charclo/Cheap-FOCer-2/source/PNGs/Back.PNG

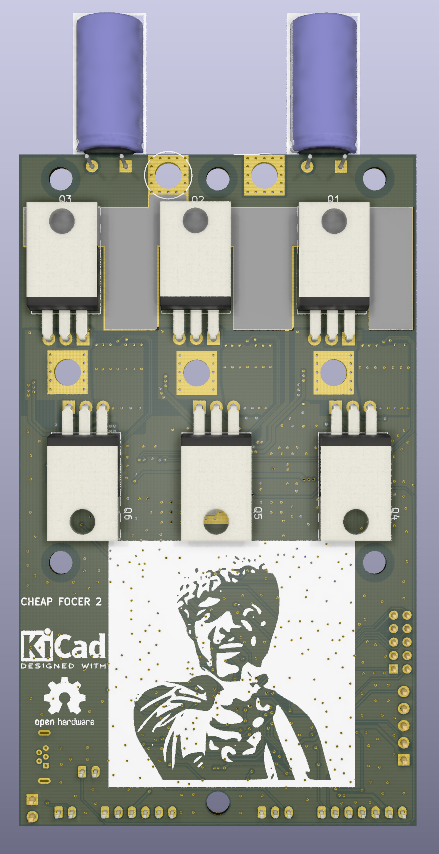
source/PNGs/Back.PNG
