charclo/Cheap-FOCer-2/source/PNGs/pinout.PNG

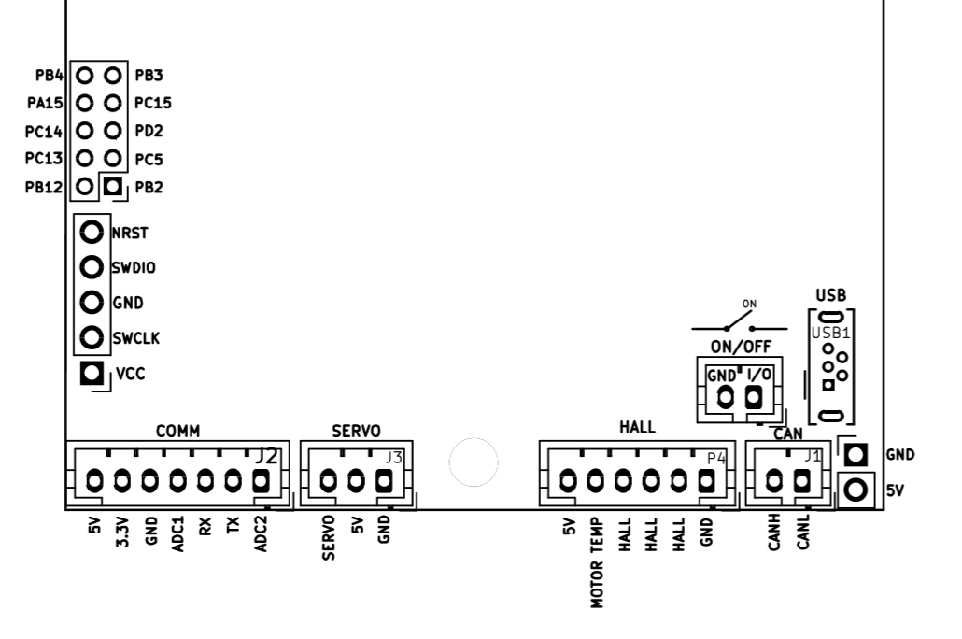
source/PNGs/pinout.PNG
