charclo/Cheap-FOCer-2/source/bom/LCSC BOM Cheap FOCer 2.xlsx

LCSC Part Number | Manufacture Part Number | Manufacturer | Customer NO. | Package | Description | RoHS | Order Qty. | Min\Mult Order Qty. | Unit Price | Order Price
C153035 | FS55X106K101EHG | PSA(Prosperity Dielectrics) |  | 2220 | Multilayer Ceramic Capacitors MLCC - SMD/SMT 10uF 100V 2220 RoHS | Yes | 3 | 1\1 | $0.516667 | $3.1
C266430 | SMNR6028-220MT | SXN(Shun Xiang Nuo Elec) |  | SMD,6x6x3mm | Inductors (SMD) SMD,6x6x3mm RoHS | Yes | 5 | 5\5 | $0.09423 | $0.47
C385986 | HMK325C7475KMHPE | Taiyo Yuden |  | 1210 | Multilayer Ceramic Capacitors MLCC - SMD/SMT 4.7uF 100V 1210 RoHS | Yes | 2 | 1\1 | $0.251515 | $1.01
C396088 | SE60210GA | SINO-IC |  | TO-220 | MOSFET N Channel 60V 210A 4V @ 250uA 2.6mΩ @ 20A,10V TO-220 RoHS | Yes | 6 | 1\1 | $0.443939 | $5.33
C437643 | 63ZLJ330M10X20 | Rubycon |  | Radial,10x20mm | Aluminum Electrolytic Capacitors - Leaded 330uF ±20% 63V Radial,10x20mm RoHS | Yes | 2 | 1\1 | $0.284848 | $1.14
