charclo/Cheap-FOCer-2/Schematic.pdf

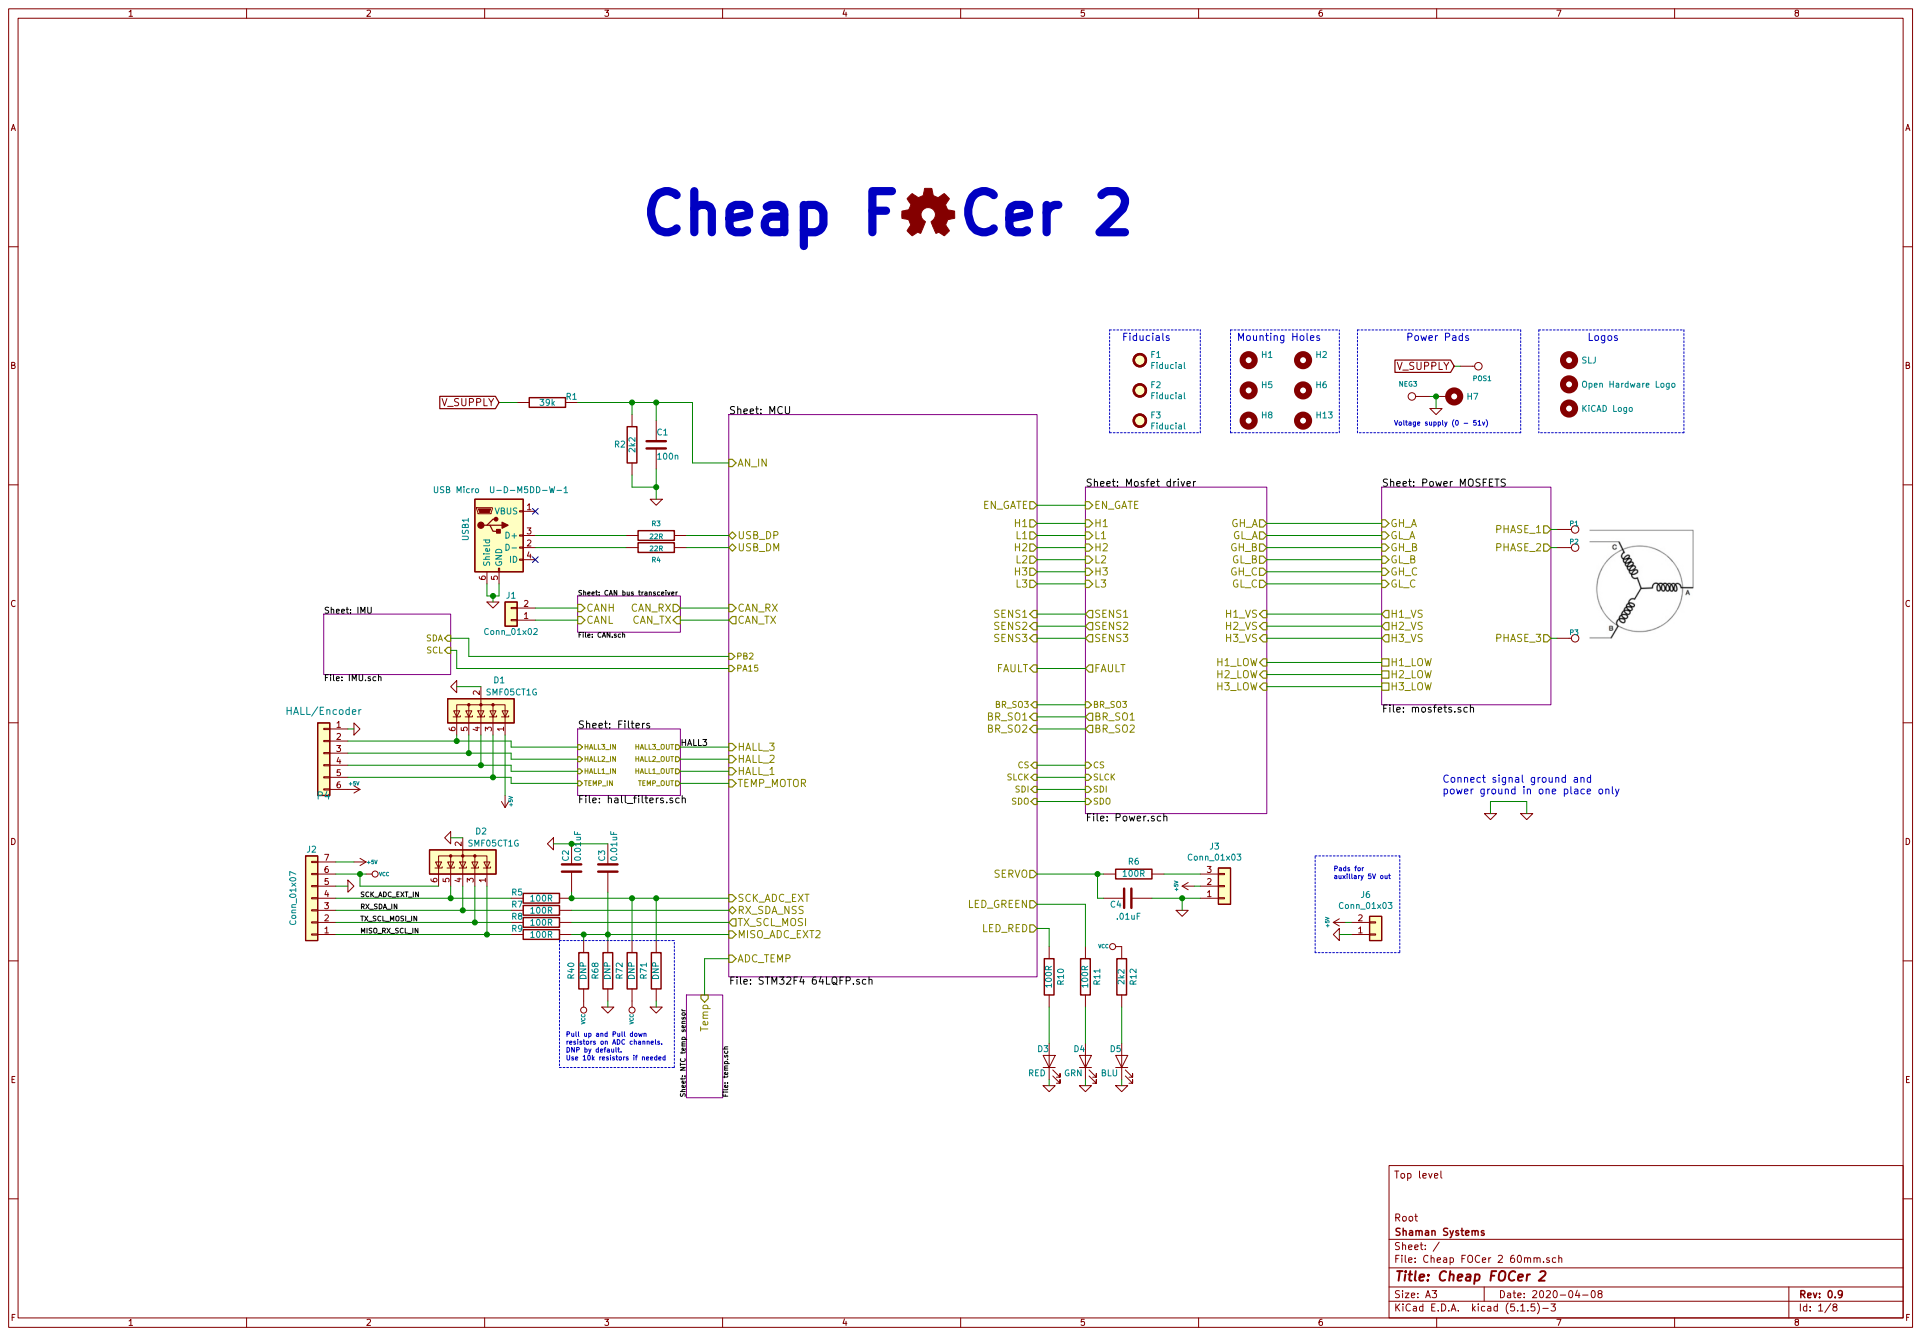
[picture p11: page 1]

power ground in one place only

Pull up and Pull down resistors on ADC channels. DNP by default. Use 10k resistors if needed

File: Cheap FOCer 2 60mm.sch Sheet: / Shaman Systems Root Top level

Id: 1/8 Title: Cheap FOCer 2

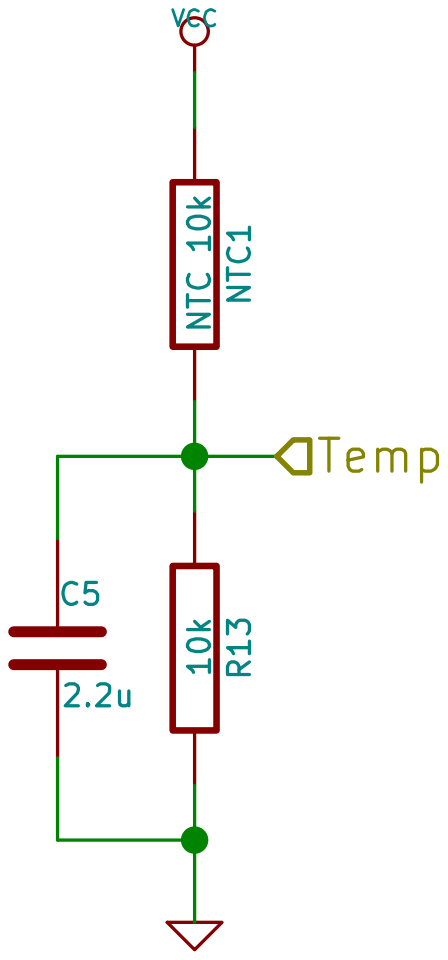
[picture p12: page 2]

Shaman Systems Root Top level 10k R13 C5

Sheet: /NTC temp sensor/
File: temp.sch
Id: 2/8 Title: Cheap FOCer 2

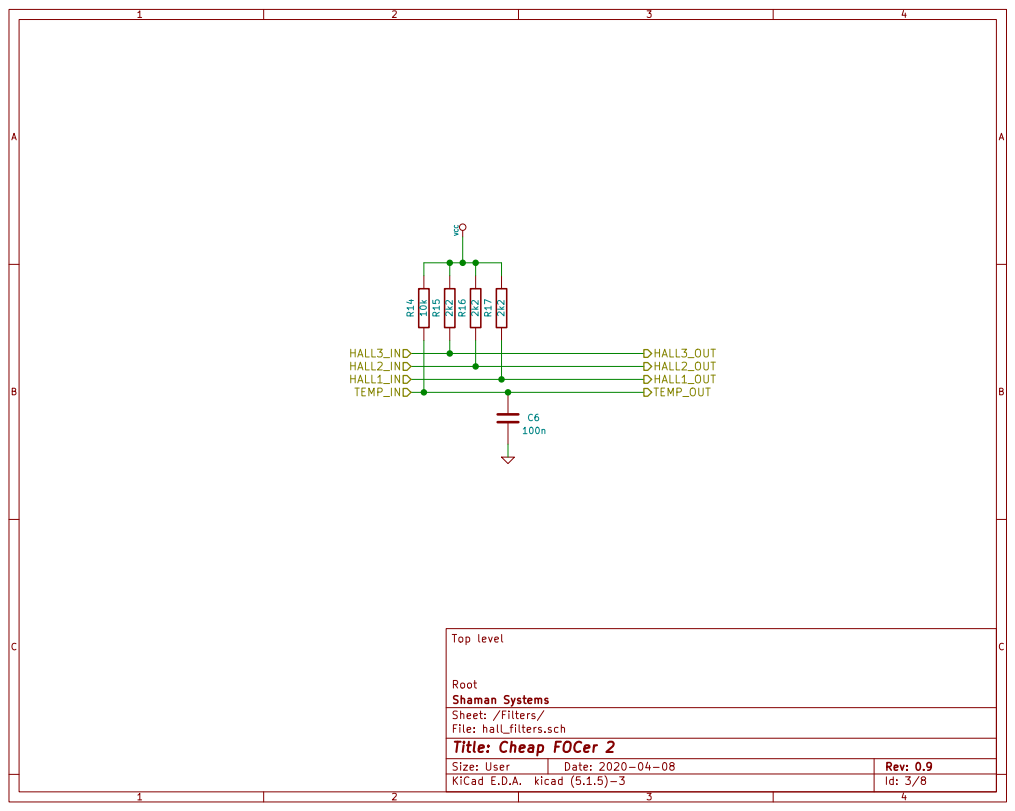
[picture p13: page 3]

Id: 3/8 Title: Cheap FOCer 2

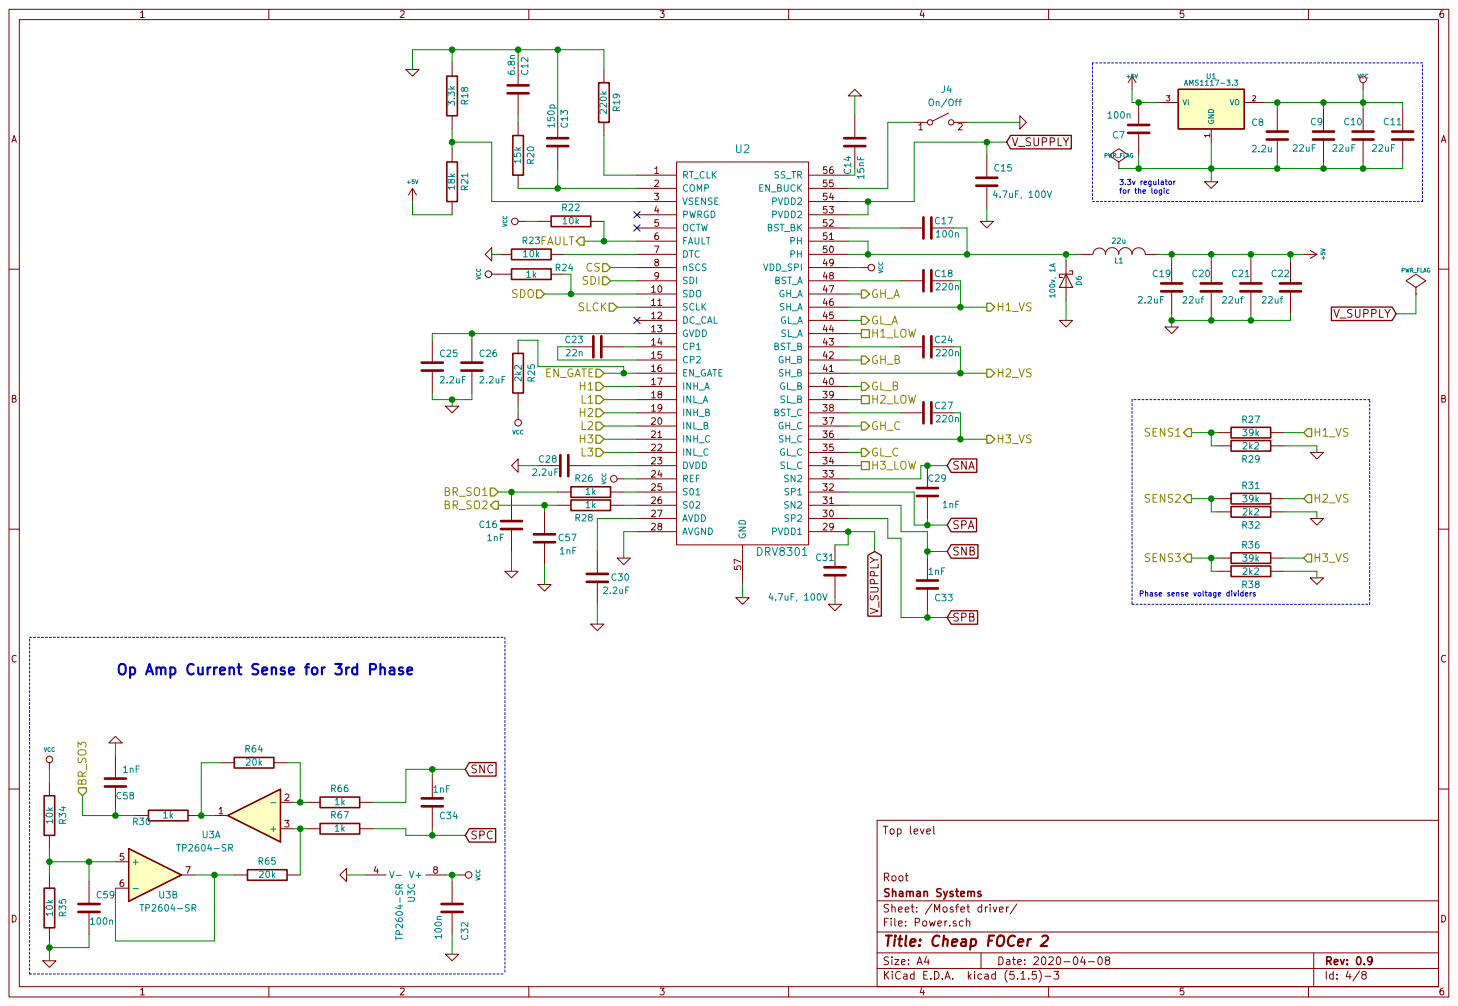
[picture p14: page 4]

for the logic Phase sense voltage dividers Op Amp Current Sense for 3rd Phase

File: Power.sch Sheet: /Mosfet driver/ Shaman Systems Root Top level VCC R67

Id: 4/8 Title: Cheap FOCer 2

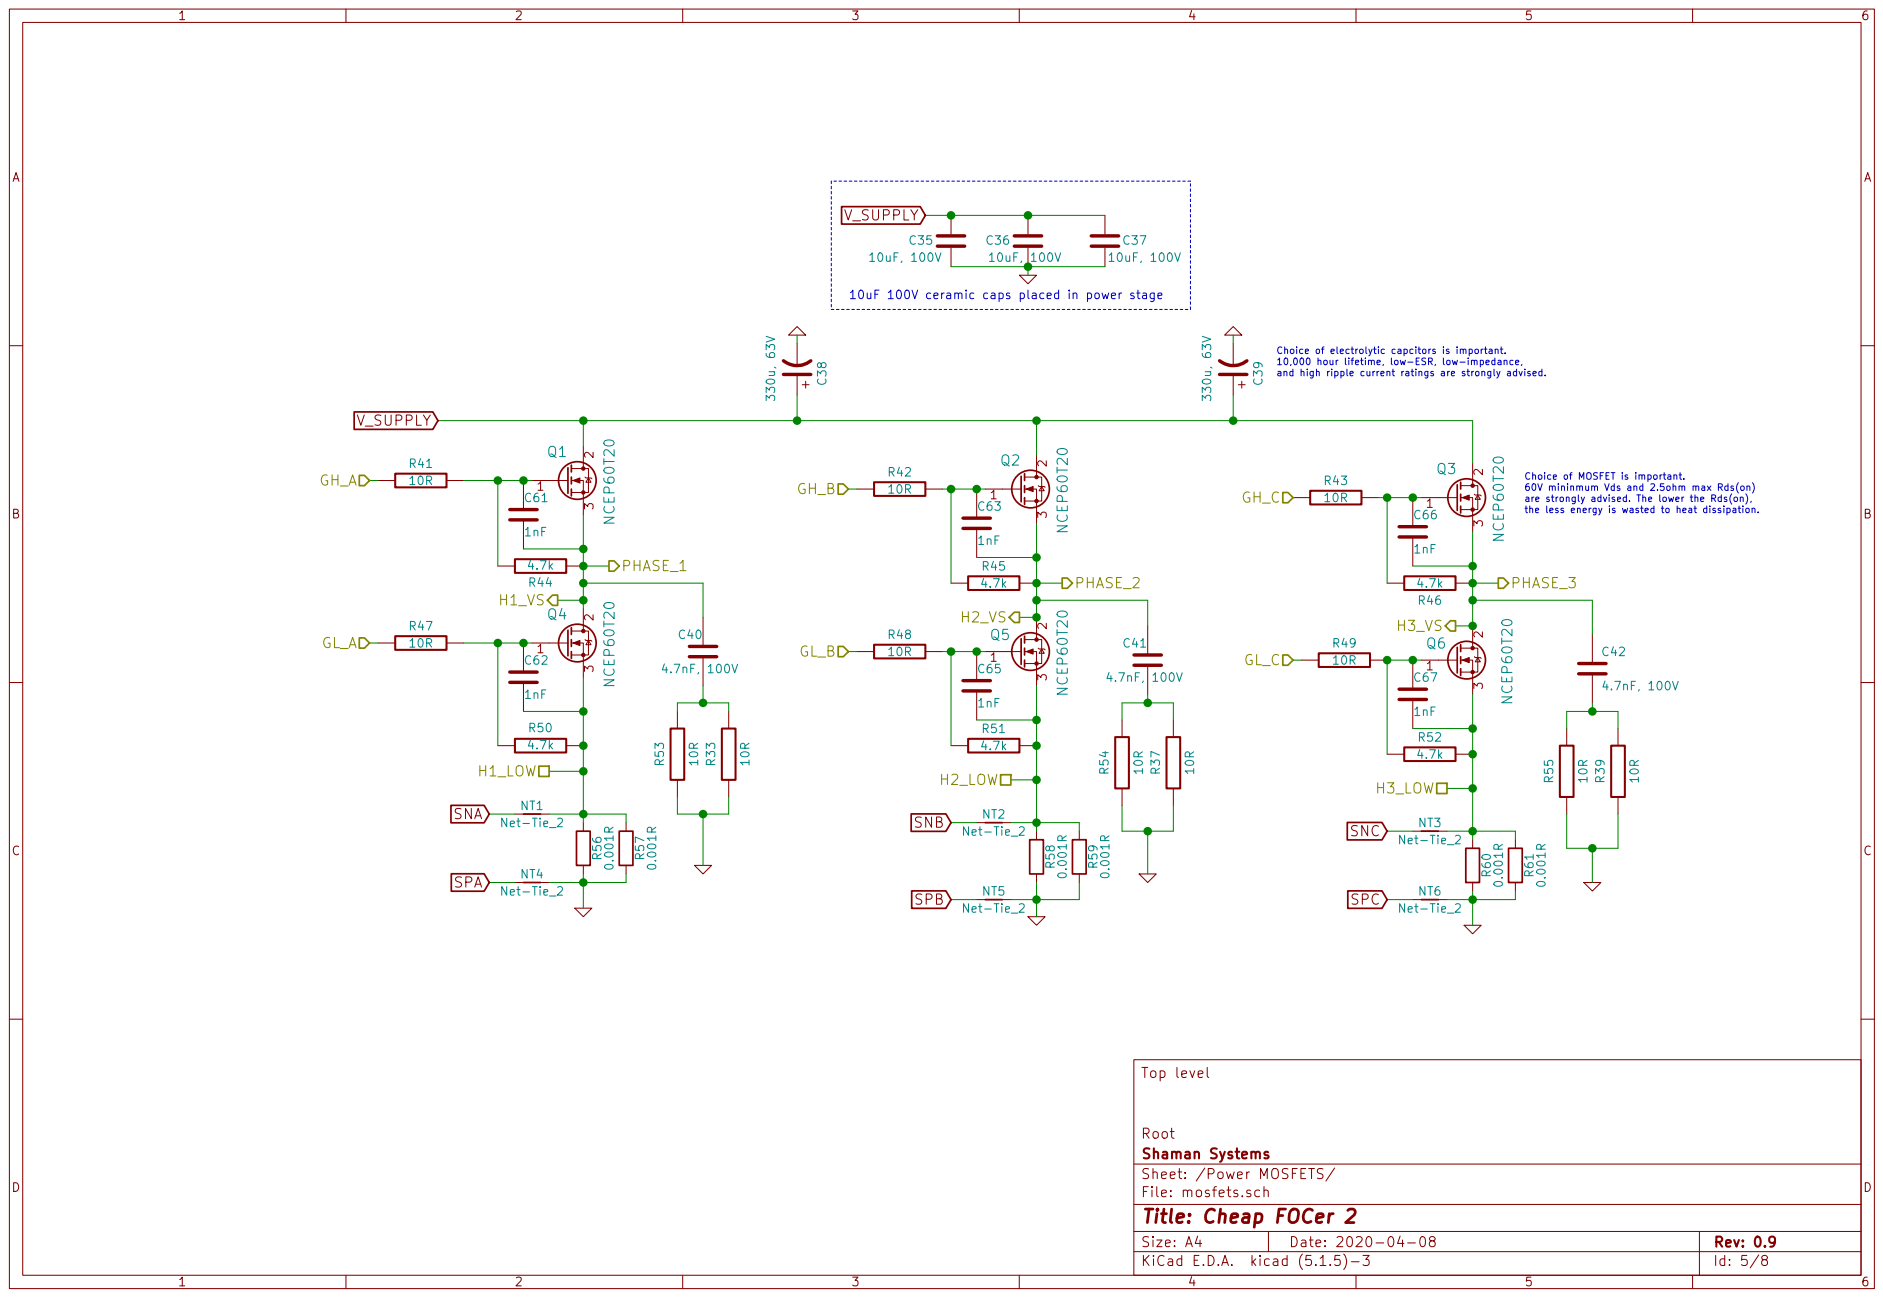
[picture p15: page 5]

the less energy is wasted to heat dissipation.

Id: 5/8 Title: Cheap FOCer 2

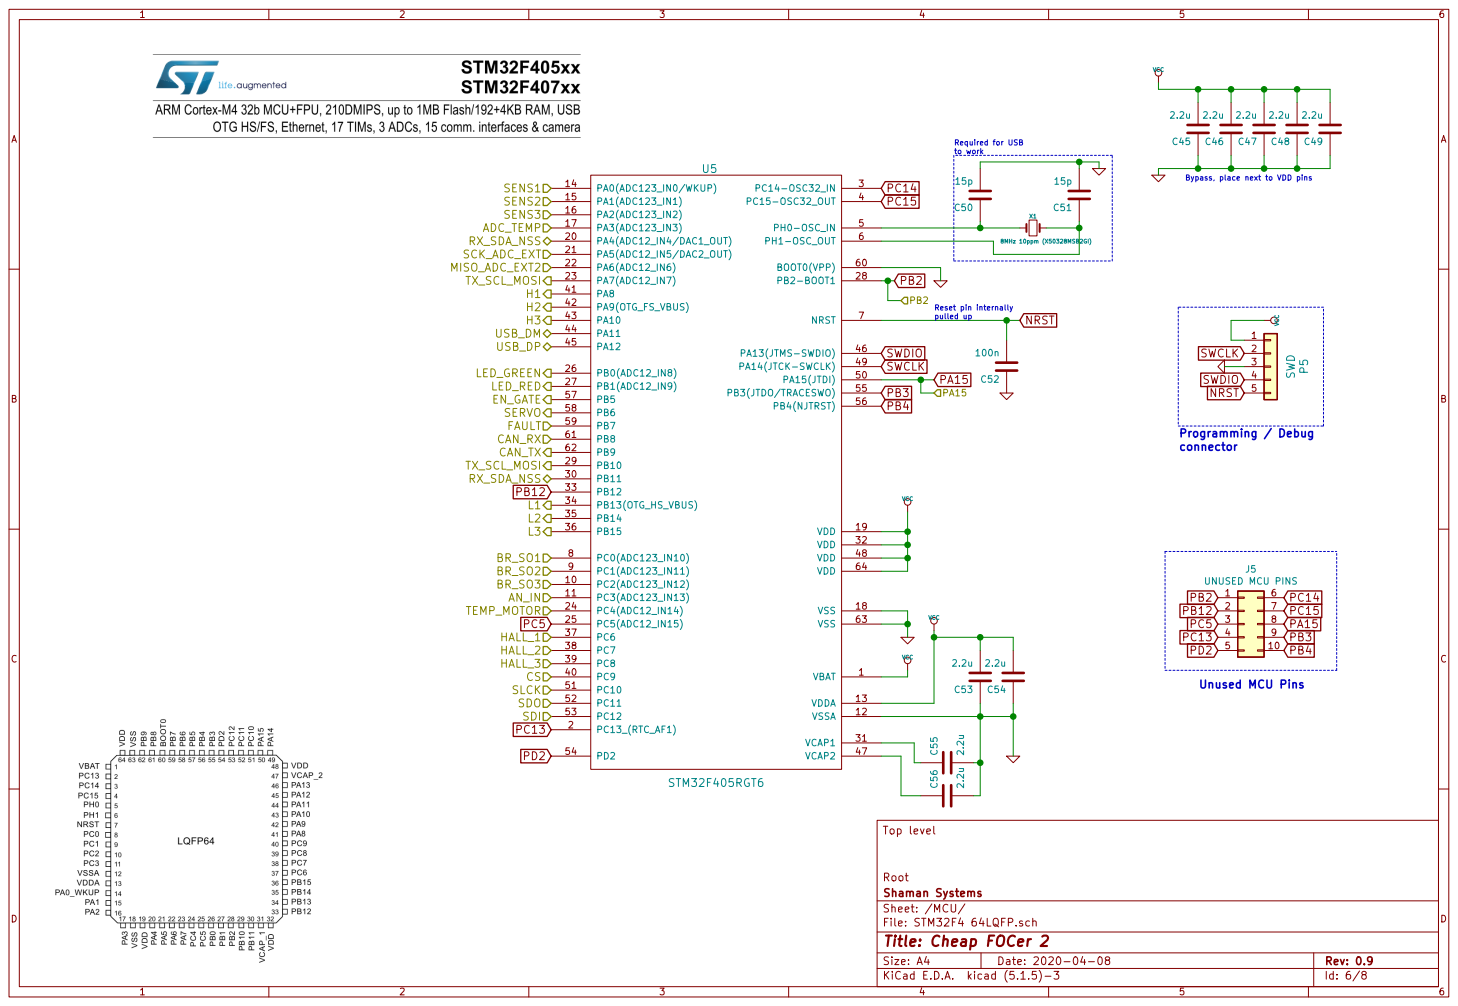
[picture p16: page 6]

Bypass, place next to VDD pins Required for USB

connector Reset pin internally pulled up

Id: 6/8 Title: Cheap FOCer 2

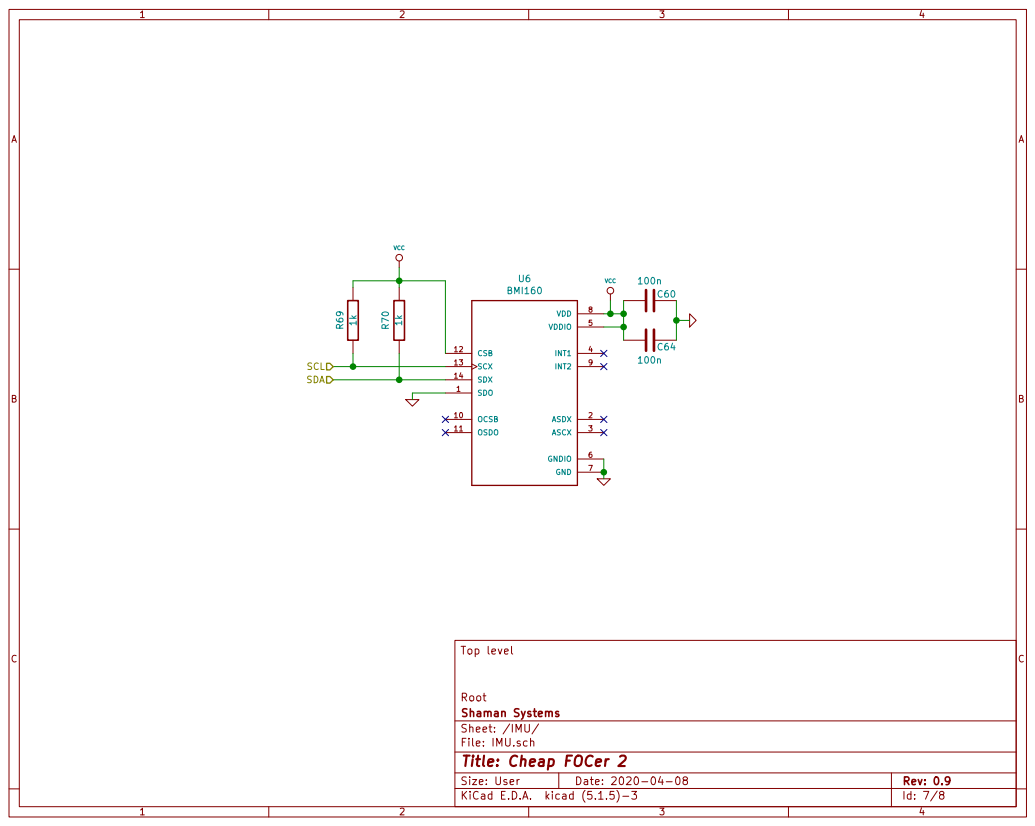
[picture p17: page 7]

Id: 7/8 Title: Cheap FOCer 2

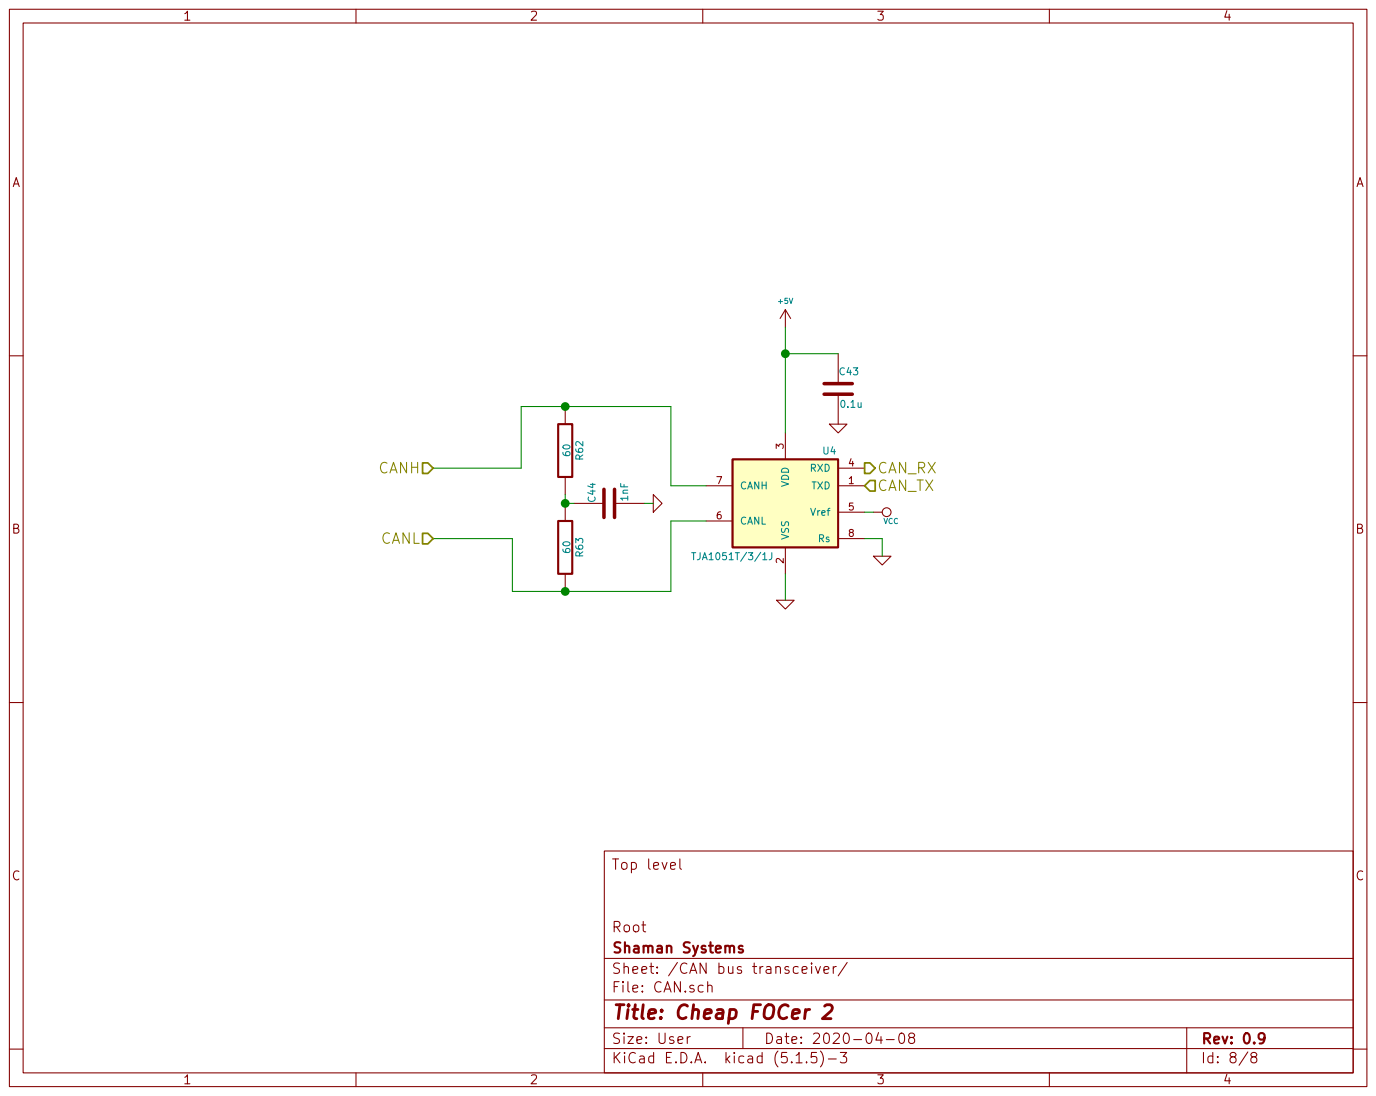
[picture p18: page 8]

3 RXD 4 Vref 5 CANL 6 CANH 7 Rs 8 U4 TJA1051T/3/1J CAN_RX

Id: 8/8 Title: Cheap FOCer 2
