charclo/Cheap-FOCer-2/(commit log)

2020-06-05 started redrawing pcb
    [Cheap FOCer 2 60mm.kicad_pcb, Cheap FOCer 2 60mm.sch, Power.sch, STM32F4 64LQFP.sch, hall_filters.sch, mosfets.sch, temp.sch]
2020-12-06 removed transistors from the gate of the mosfets and fixed the config file for compiling the firmware
    [Cheap FOCer 2 60mm.kicad_pcb, mosfets.sch]
2021-06-25 Updated Schematic and PNG's
2021-06-25 Moved component descriptors and updated ibom
    [Cheap FOCer 2 60mm.kicad_pcb]
2021-06-25 Put back Q6 which was accidentally deleted
    [Cheap FOCer 2 60mm.kicad_pcb, Cheap FOCer 2 60mm.sch, IMU.sch, mosfets.sch]
2021-06-25 Added v0.9 and v1 support, deleted backup files
    [CAN.sch, IMU.sch, Power.sch, STM32F4 64LQFP.sch, hall_filters.sch, temp.sch]
2021-06-26 Deleted old BOM files
    [JLCPCB BOM Cheap FOCer 2.xlsx, LCSC BOM Cheap FOCer 2.xlsx, bom.csv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]
2021-06-26 Updated gerber files
    [Cheap FOCer 2 60mm-B_Mask.gbr, Cheap FOCer 2 60mm-B_Paste.gbr, Cheap FOCer 2 60mm-B_SilkS.gbr, Cheap FOCer 2 60mm-Bottom_Signal.gbr, Cheap FOCer 2 60mm-Edge_Cuts.gbr, Cheap FOCer 2 60mm-F_Mask.gbr, Cheap FOCer 2 60mm-F_Paste.gbr, Cheap FOCer 2 60mm-F_SilkS.gbr]
2021-06-26 Removed gate transistors
    [CAN.sch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]
2021-06-26 Revert "Remove transistors"
    [CAN.sch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]
2021-06-26 Revert "Removed gate transistors"
    [CAN.sch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]
